RoboticsBrno/Robotarna_KiCad_Library/Robotarna_KiCad_Library/RKL_3Dmodels/BC-18650-PC4.step

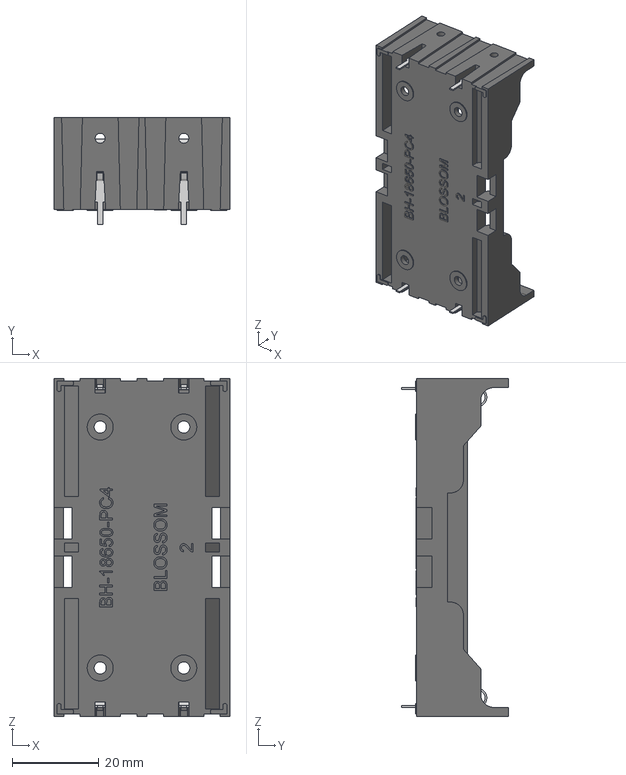
[picture p1: CAD file, 2025-06-09]
Robotarna_KiCad_Library/RKL_3Dmodels/BC-18650-PC4.step
40.5 x 24.7 x 78.0 mm
Деталь2^Отсек акк умуляторный BC-18650-PC4
Деталь3^Отсек акк умуляторный BC-18650-PC4 x 4
