RoboticsBrno/Robotarna_KiCad_Library/Robotarna_KiCad_Library/RKL_3Dmodels/ITR8307-S17-TR8 v2.step

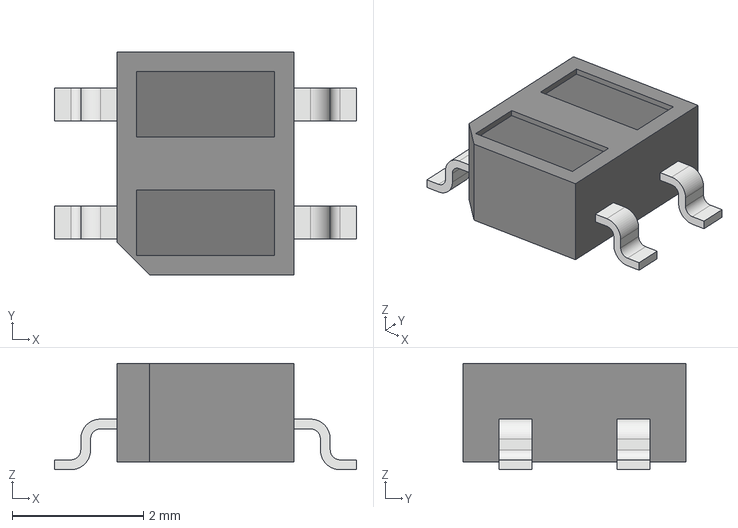
[picture p2: CAD file, 2024-07-02]
Robotarna_KiCad_Library/RKL_3Dmodels/ITR8307-S17-TR8 v2.step
4.60 x 3.40 x 1.62 mm
