RoboticsBrno/Robotarna_KiCad_Library/Robotarna_KiCad_Library/RKL_3Dmodels/PEC11H-4220F-S0024--3DModel-STEP-269445.STEP

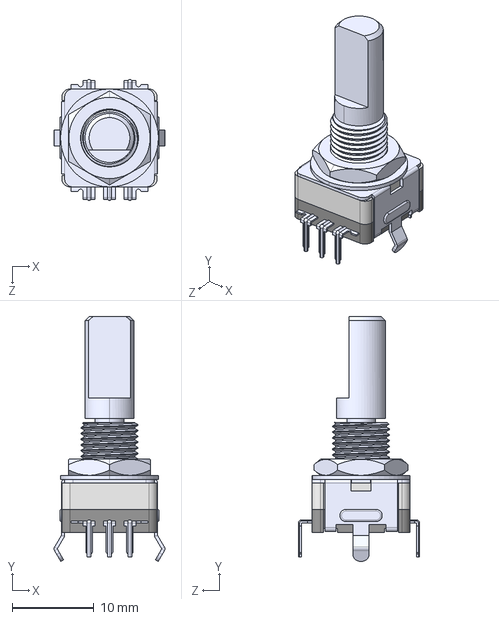
[picture p3: CAD file, 2024-04-26]
Robotarna_KiCad_Library/RKL_3Dmodels/PEC11H-4220F-S0024--3DModel-STEP-269445.STEP
13.6 x 30.1 x 14.9 mm
