RoboticsBrno/Robotarna_KiCad_Library/Robotarna_KiCad_Library/RKL_3Dmodels/LED_WS2812B_PLCC4_5.0x5.0mm_P3.2mm.step

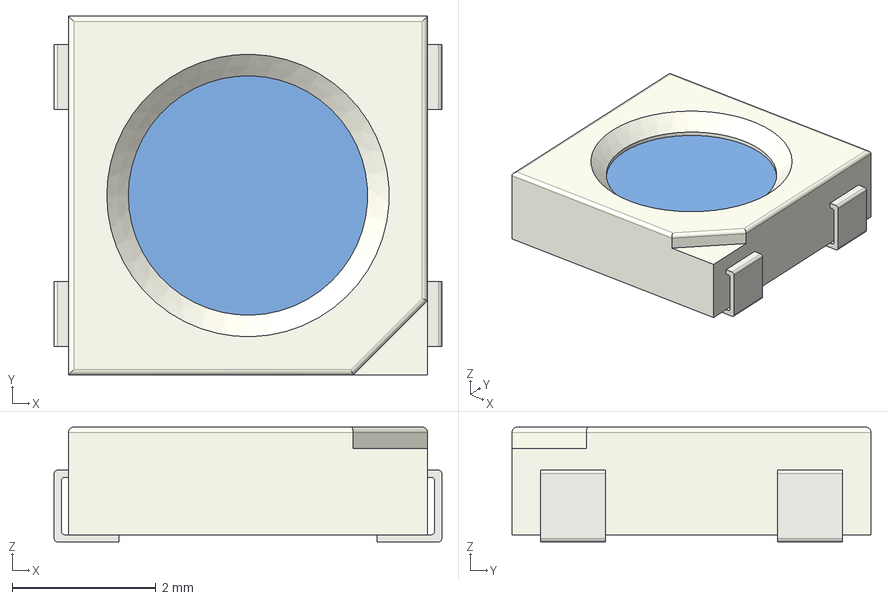
[picture p4: CAD file, 2024-04-26]
Robotarna_KiCad_Library/RKL_3Dmodels/LED_WS2812B_PLCC4_5.0x5.0mm_P3.2mm.step
5.40 x 5.00 x 1.60 mm
