RoboticsBrno/Robotarna_KiCad_Library/Robotarna_KiCad_Library/RKL_3Dmodels/ESP32-S3-WROOM-1-N8R2--3DModel-STEP-56544.STEP

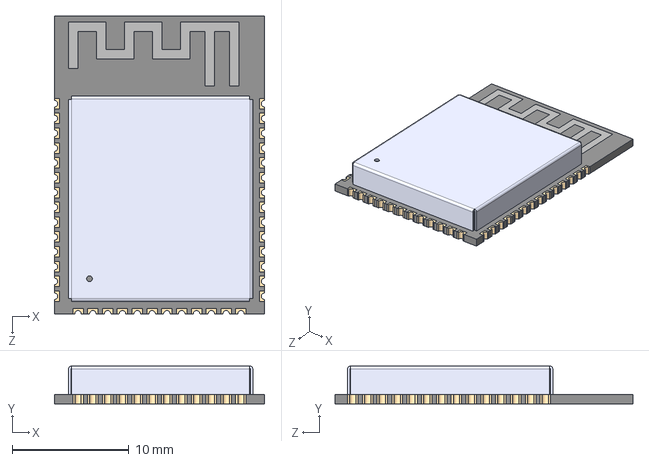
[picture p5: CAD file, 2024-04-08]
Robotarna_KiCad_Library/RKL_3Dmodels/ESP32-S3-WROOM-1-N8R2--3DModel-STEP-56544.STEP
18.0 x 3.25 x 25.5 mm
