RoboticsBrno/Robotarna_KiCad_Library/Robotarna_KiCad_Library/RKL_3Dmodels/USB-C-waterproof.step

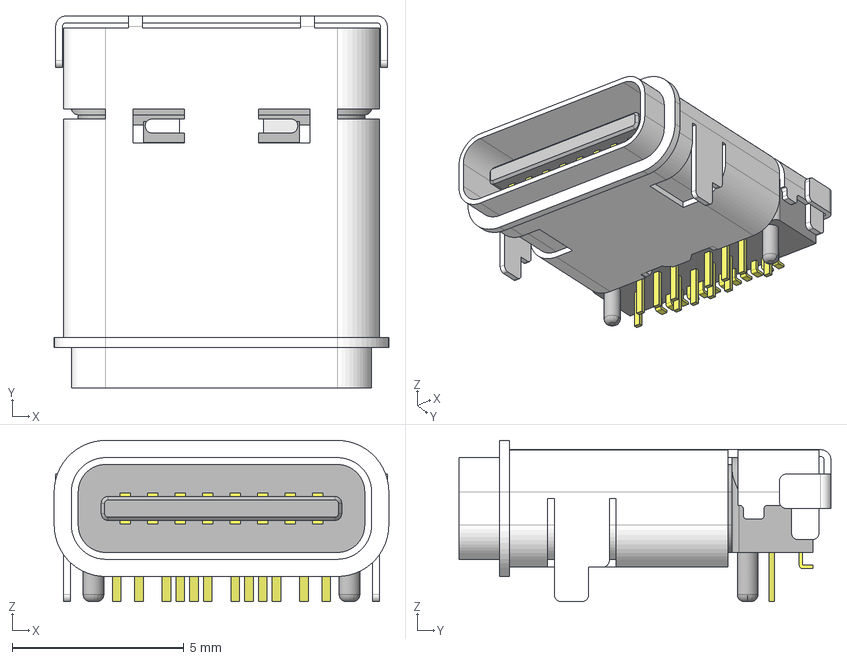
[picture p6: CAD file, 2024-04-08]
Robotarna_KiCad_Library/RKL_3Dmodels/USB-C-waterproof.step
9.74 x 10.8 x 4.69 mm
