RoboticsBrno/Robotarna_KiCad_Library/Robotarna_KiCad_Library/RKL_3Dmodels/ESP32-C3-MINI-1-N4--3DModel-STEP-1.STEP

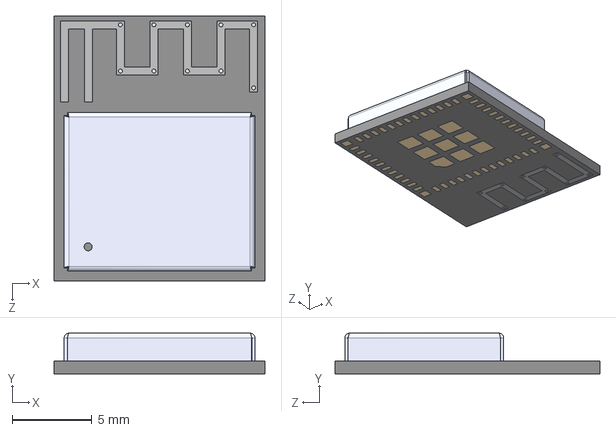
[picture p7: CAD file, 2024-04-08]
Robotarna_KiCad_Library/RKL_3Dmodels/ESP32-C3-MINI-1-N4--3DModel-STEP-1.STEP
13.2 x 2.55 x 16.6 mm
