RoboticsBrno/Robotarna_KiCad_Library/Robotarna_KiCad_Library/RKL_3Dmodels/USB-C-vertical.step

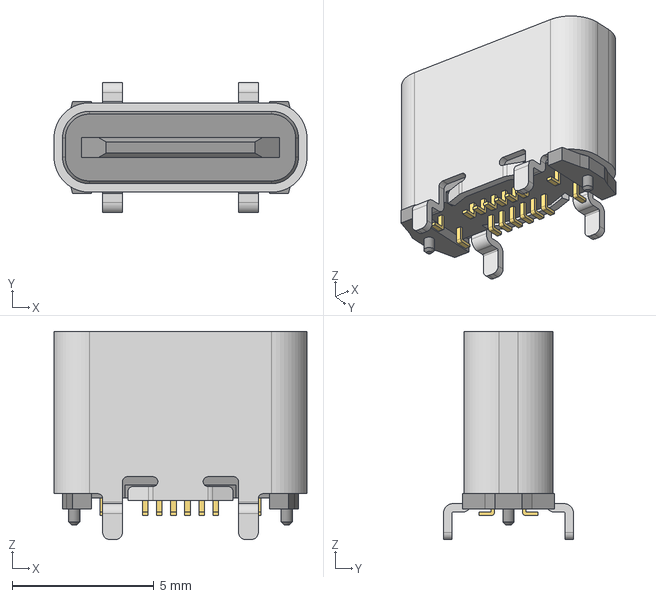
[picture p8: CAD file, 2024-03-19]
Robotarna_KiCad_Library/RKL_3Dmodels/USB-C-vertical.step
8.94 x 4.60 x 7.35 mm
