RoboticsBrno/Robotarna_KiCad_Library/Robotarna_KiCad_Library/RKL_3Dmodels/DFN3030.step

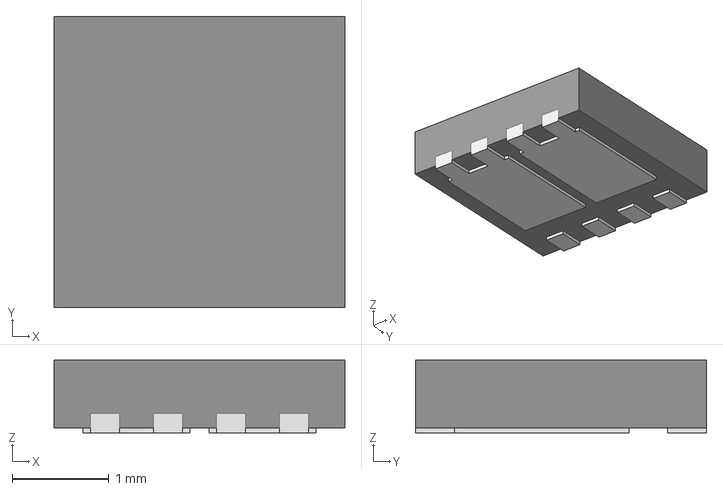
[picture p9: CAD file, 2024-03-14]
Robotarna_KiCad_Library/RKL_3Dmodels/DFN3030.step
3.00 x 3.00 x 0.75 mm
