RoboticsBrno/Robotarna_KiCad_Library/Robotarna_KiCad_Library/RKL_3Dmodels/radoby_cecko.step

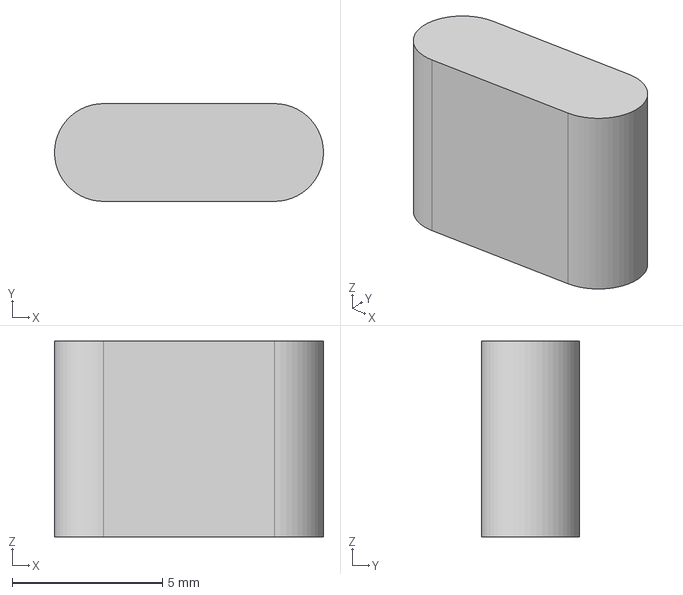
[picture p10: CAD file, 2024-03-14]
Robotarna_KiCad_Library/RKL_3Dmodels/radoby_cecko.step
8.94 x 3.25 x 6.50 mm
