RoboticsBrno/Robotarna_KiCad_Library/Robotarna_KiCad_Library/RKL_3Dmodels/WS2812-1010.step

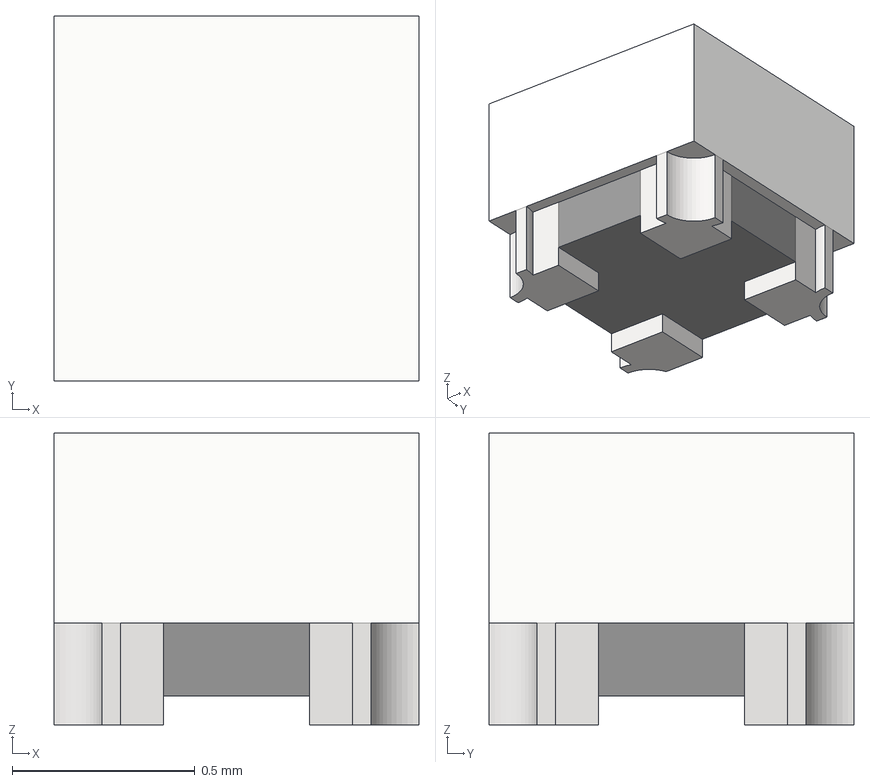
[picture p11: CAD file, 2024-03-14]
Robotarna_KiCad_Library/RKL_3Dmodels/WS2812-1010.step
1.00 x 1.00 x 0.8 mm
