RoboticsBrno/Robotarna_KiCad_Library/Robotarna_KiCad_Library/RKL_3Dmodels/Button_(SKRPADE010).step

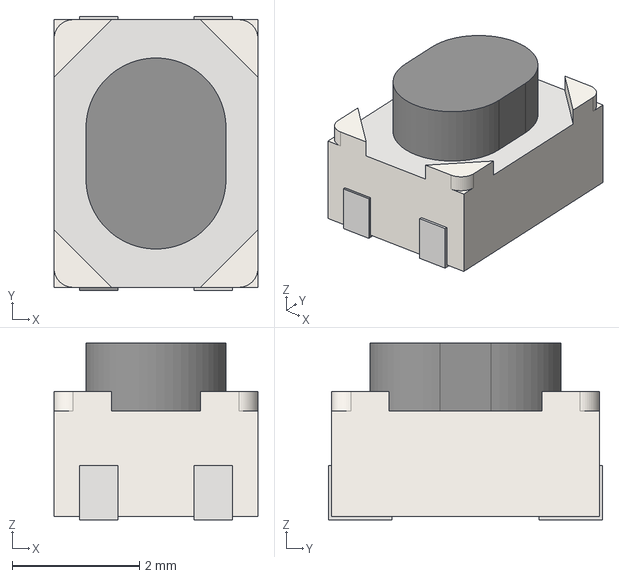
[picture p12: CAD file, 2024-03-14]
Robotarna_KiCad_Library/RKL_3Dmodels/Button_(SKRPADE010).step
3.20 x 4.30 x 2.77 mm
