RoboticsBrno/Robotarna_KiCad_Library/Robotarna_KiCad_Library/RKL_3Dmodels/Buzzer_4x4x2_(GSC4317YA-16R4000).step

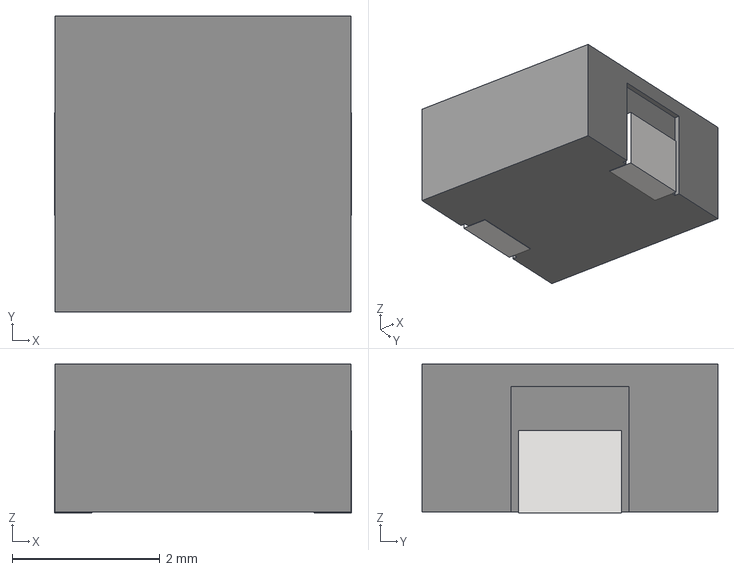
[picture p13: CAD file, 2024-03-14]
Robotarna_KiCad_Library/RKL_3Dmodels/Buzzer_4x4x2_(GSC4317YA-16R4000).step
4.02 x 4.00 x 2.01 mm
