RoboticsBrno/Robotarna_KiCad_Library/Robotarna_KiCad_Library/RKL_3Dmodels/ESP32-S3-MINI-1-N8--3DModel-STEP-1.STEP

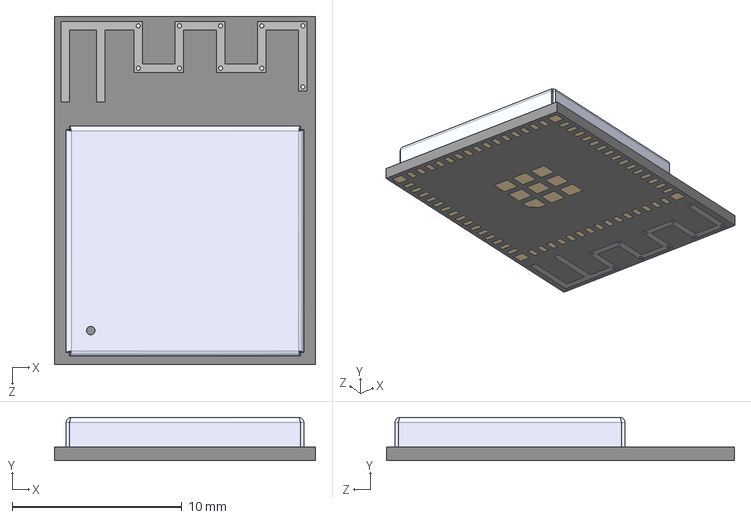
[picture p14: CAD file, 2024-03-12]
Robotarna_KiCad_Library/RKL_3Dmodels/ESP32-S3-MINI-1-N8--3DModel-STEP-1.STEP
15.4 x 2.55 x 20.5 mm
