RoboticsBrno/Robotarna_KiCad_Library/Robotarna_KiCad_Library/RKL_3Dmodels/button-(TCF2QR).step

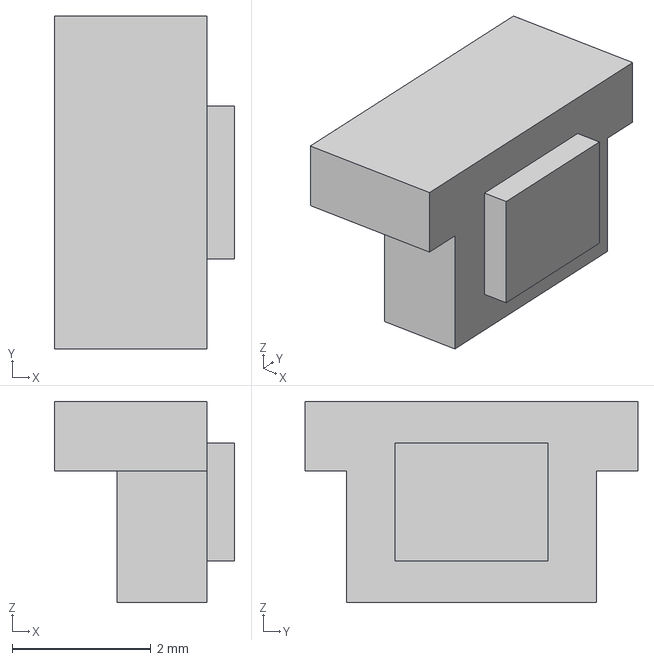
[picture p15: CAD file, 2024-03-12]
Robotarna_KiCad_Library/RKL_3Dmodels/button-(TCF2QR).step
2.60 x 4.80 x 2.90 mm
