RoboticsBrno/Robotarna_KiCad_Library/Robotarna_KiCad_Library/RKL_3Dmodels/WS2812B-2020.step

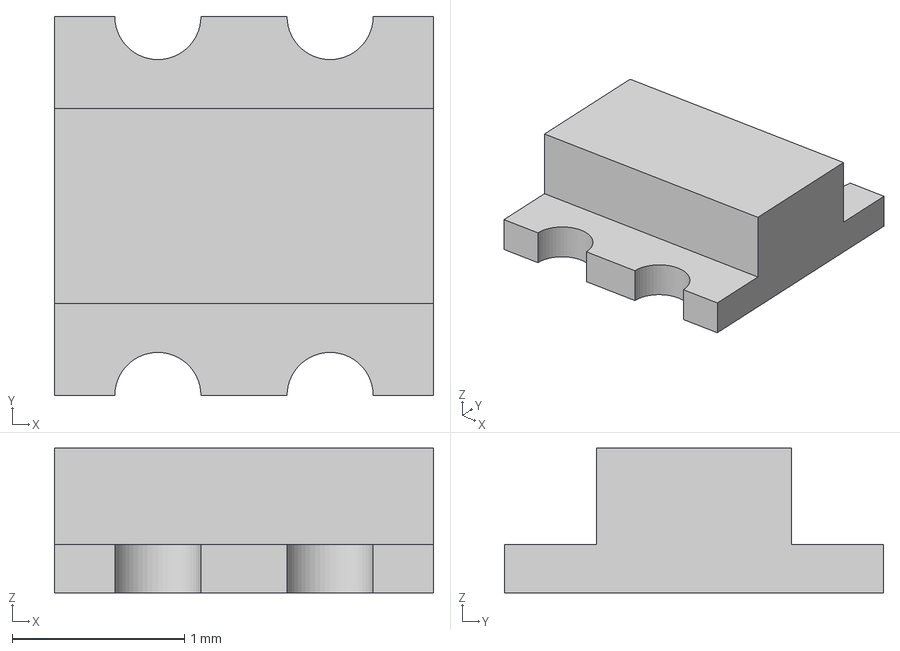
[picture p16: CAD file, 2024-03-03]
Robotarna_KiCad_Library/RKL_3Dmodels/WS2812B-2020.step
2.20 x 2.20 x 0.84 mm
