RoboticsBrno/Robotarna_KiCad_Library/(commit log)

2023-01-21 Adding some parts from existing projects
    [Robotarna_KiCad_Library.kicad_pcb, Robotarna_KiCad_Library.kicad_sch]
2023-02-12 ESP32 S3 WROOM
2023-04-03 Add footprint to ESP32-C3-MINI-1
2023-04-03 LD39200 and rename USB-PCB
2023-07-23 New piezzo, potentiometer, hack for ESP32S3 and dual MOSFET sch simbol
    The hack is for assembly pins pro ESP32S3 devkit or other problematics pin headers
2023-08-03 Fix ESP32-C3-MINI-1
2023-09-23 edit STM32H503 sch symbol
2023-12-20 ESP32_DevkitC4 and addition of several attributes
2023-12-20 Sorting footprints
2024-02-20 Delet solder_mask_margin
2024-02-20 Add RKL_MEMS with LIS2DH12 (accelerometer)
2024-03-12 3D models
    [button-(TCF2QR).step]
2024-03-12 Narrowing of M2 connector
2024-03-14 FPC connector 01x04_0.5mm
2024-03-14 Linear PCB coil
2024-03-19 USB-C_vertical 3D model
    [USB-C-vertical.step]
2024-04-25 Added RotaryEncoder
    [PEC11H-4220F-S0024--3DModel-STEP-269445.STEP]
2024-04-25 Fix ESP32-S3-MINI 3D model path
2024-04-25 Add XL-3528RGBW-WS2812B
    [LED_WS2812B_PLCC4_5.0x5.0mm_P3.2mm.step]
2024-04-25 Cange KiCad version in README
2024-04-25 Add LED as proxy 3D model of phototranzistor SMD3528C-50
2025-06-23 Kicad 9
2026-01-08 ESP32-S3 fix IO3 label
2026-03-27 XL-3014 LED footprint
