RoboticsBrno/Robotarna_KiCad_Library/(notices)

Notices in the files:
Robotarna_KiCad_Library/RKL_3Dmodels/LED_WS2812B_PLCC4_5.0x5.0mm_P3.2mm.step:
Copyright (C) 2019, kicad StepUp
This work is licensed under the [Creative Commons CC-BY-SA 4.0 License](https://creativecommons.org/licenses/by-sa/4.0/legalcode),
with the following exception:
To the extent that the creation of electronic designs that use 'Licensed Material' can be considered to be 'Adapted Material',
You are free to use the library data in your own projects without the obligation to share your project files under this or any other license agreement.
